algofoogle/gf180mcuD-netgen-lvs-example/(commit log)

2026-05-28 Very rough initial inverter attempts. Trying to get LVS to work
    [inverter.sch]
2026-05-31 Passing gf180mcuD magic/netgen LVS for basic CMOS inverter
    [inverter.sch]
